c0d3z3r0/qiroll_rev/PICTURES.md

# Qiroll E-PRO Reverse Engineering : Pictures

## Battery


Note: that blue push button was added by me





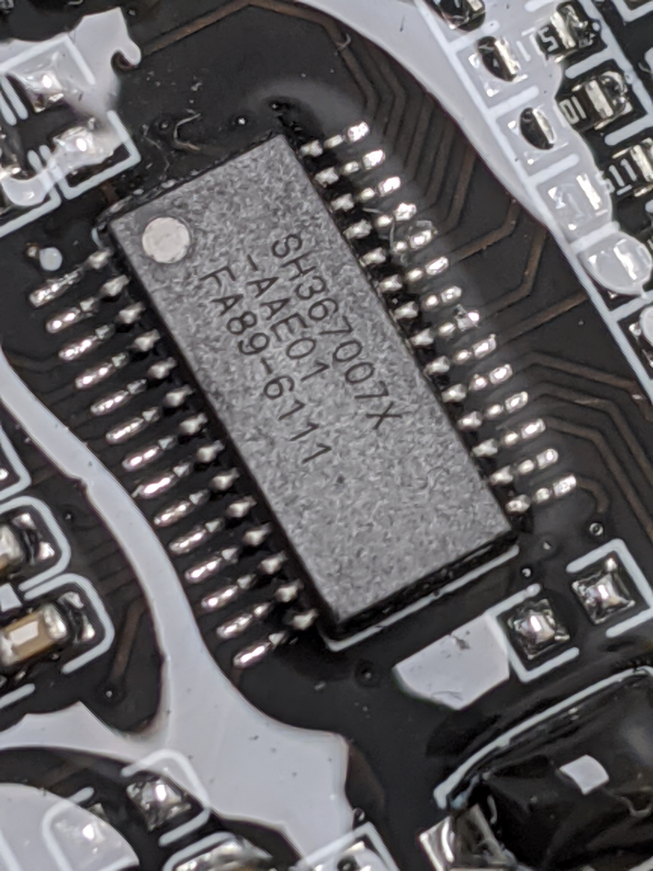
[picture p2: images/battery_pcb_SH367007.jpg]


## S2 Switch



## Qiroll disassembly

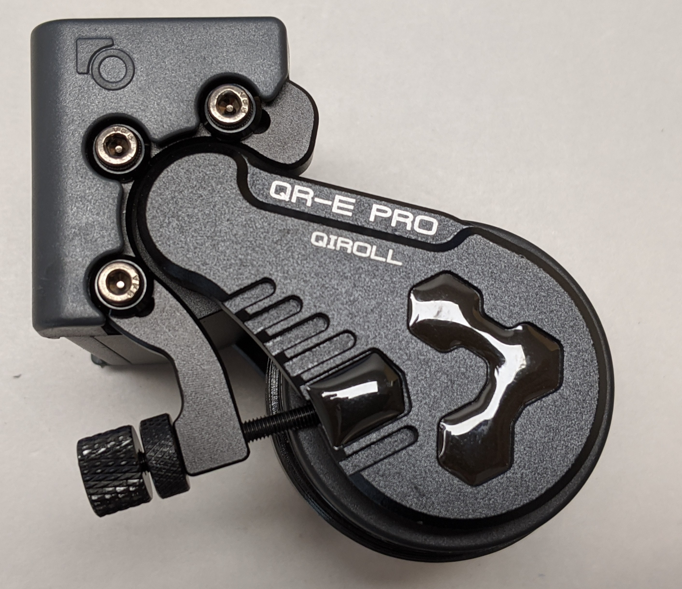
[picture p3: images/qiroll_pro.jpg]



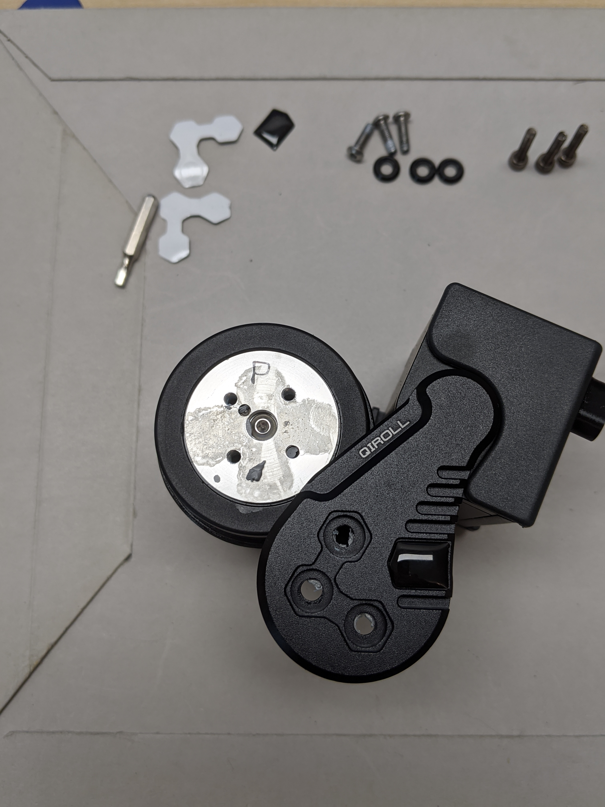
[picture p5: images/qiroll_disassembly_3.jpg]




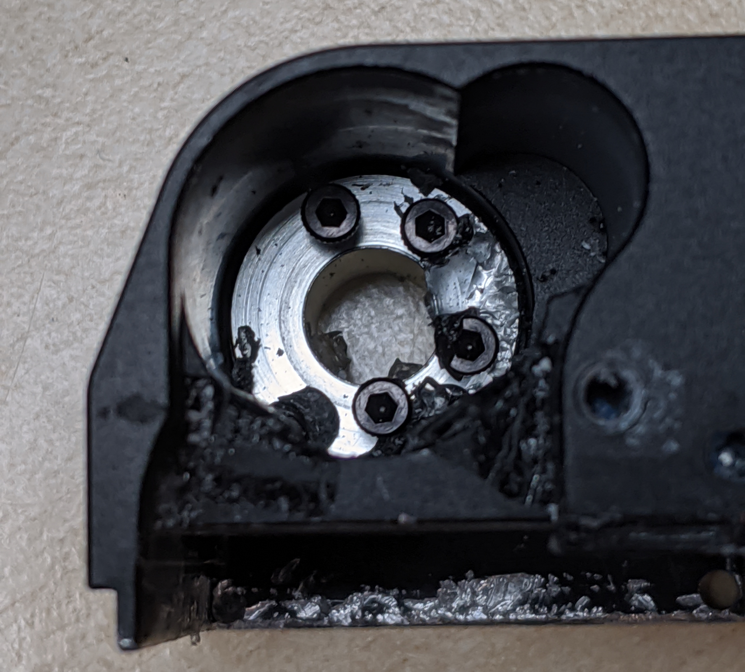
[picture p6: images/qiroll_disassembly_7.jpg]
