c0d3z3r0/qiroll_rev/schematic/qiroll.pdf

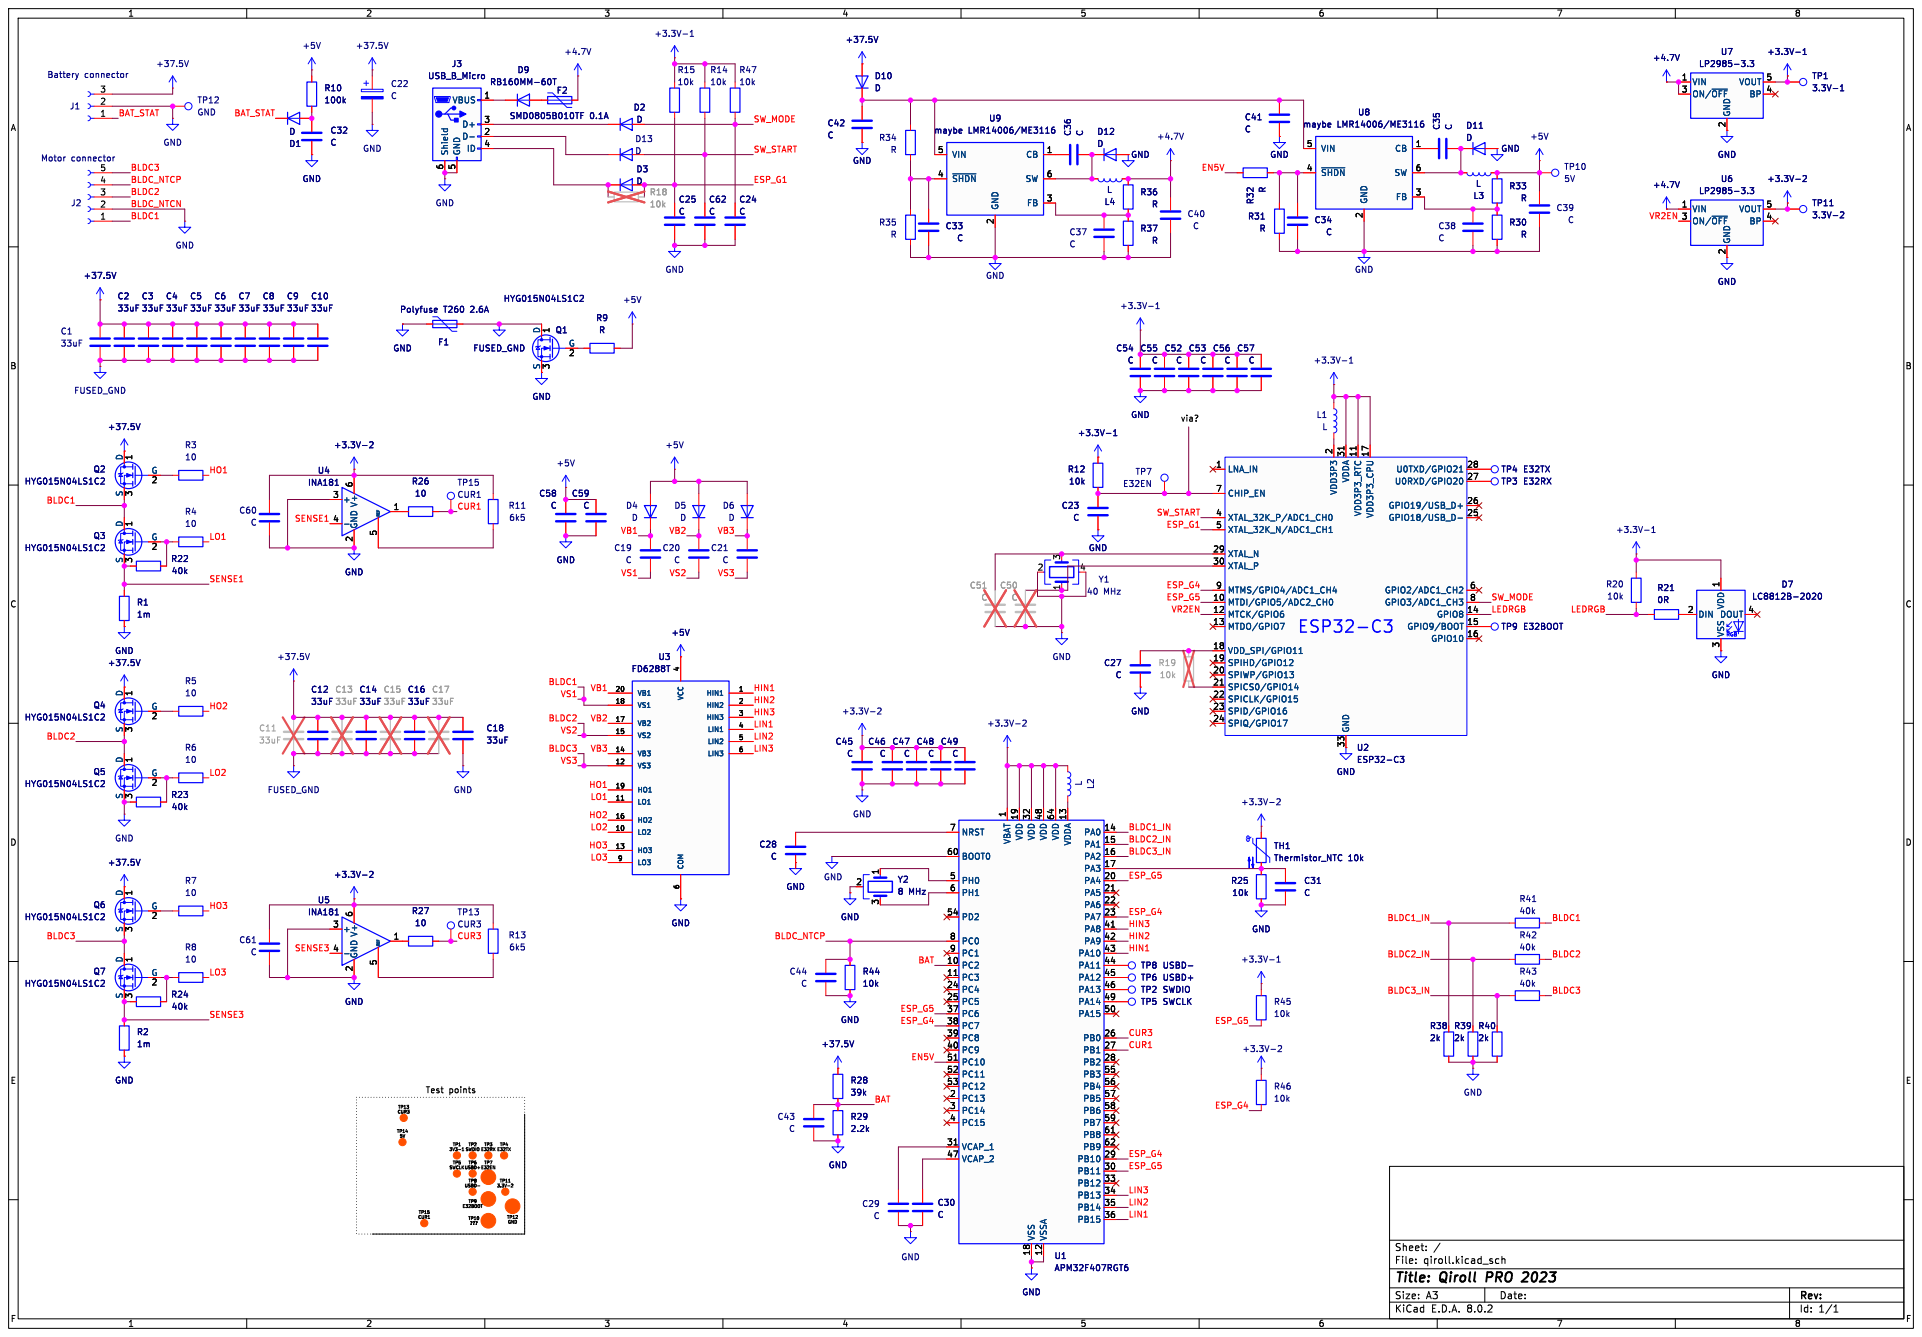
[picture p7: page 1]

2 FB 3 ~{SHDN} 4 VIN 5 SW 6 U9 maybe LMR14006/ME3116 C50C

2 FB 3 ~{SHDN} 4 VIN 5 SW 6 U8 maybe LMR14006/ME3116 C34C

2 FB 3 ~{SHDN} 4 VIN 5 SW 6 D12 D GND C36 C

2 FB 3 ~{SHDN} 4 VIN 5 SW 6 C34C

2 SPIWP/GPIO13 20 SPICS0/GPIO14 21 SPICLK/GPIO15 22 SPID/GPIO16 23 SPIQ/GPIO17 24 GPIO18/USB_D- 25 GPIO19/USB_D+ 26 U0RXD/GPIO20 27 U0TXD/GPIO21 28 XTAL_N 29 XTAL_P 30 VDDA 31 GND 33 XTAL_32K_P/ADC1_CH0 4 XTAL_32K_N/ADC1_CH1 5 GPIO2/ADC1_CH2 6 CHIP_EN 7 GPIO3/ADC1_CH3 8 MTMS/GPIO4/ADC1_CH4 9 U2ESP32-C3

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

1 PC2 10 PC3 11 VSSA 12 VDDA 13 PA0 14 PA1 15 PA2 16 PA3 17 VSS 18 VDD 19 PC13 2 PA4 20 PA5 21 PA6 22 PA7 23 PC4 24 PC5 25 PB0 26 PB1 27 PB2 28 PB10 29 PC14 3 PB11 30 VCAP_1 31 VDD 32 PB12 33 PB13 34 PB14 35 PB15 36 PC6 37 PC7 38 PC8 39 PC15 4 PC9 40 PA8 41 PA9 42 PA10 43 PA11 44 PA12 45 PA13 46 VCAP_2 47 VDD 48 PA14 49 PH0 5 PA15 50 PC10 51 PC11 52 PC12 53 PD2 54 PB3 55 PB4 56 PB5 57 PB6 58 PB7 59 PH1 6 BOOT0 60 PB8 61 PB9 62 VDD 64 NRST 7 PC0 8 PC1 9 C27C GND

1 PC2 10 PC3 11 VSSA 12 VDDA 13 PA0 14 PA1 15 PA2 16 PA3 17 VSS 18 VDD 19 PC13 2 PA4 20 PA5 21 PA6 22 PA7 23 PC4 24 PC5 25 PB0 26 PB1 27 PB2 28 PB10 29 PC14 3 PB11 30 VCAP_1 31 VDD 32 PB12 33 PB13 34 PB14 35 PB15 36 PC6 37 PC7 38 PC8 39 PC15 4 PC9 40 PA8 41 PA9 42 PA10 43 PA11 44 PA12 45 PA13 46 VCAP_2 47 VDD 48 PA14 49 PH0 5 PA15 50 PC10 51 PC11 52 PC12 53 PD2 54 PB3 55 PB4 56 PB5 57 PB6 58 PB7 59 PH1 6 BOOT0 60 PB8 61 PB9 62 VDD 64 NRST 7 PC0 8 PC1 9 U1APM32F407RGT6 GND

File: qiroll.kicad_sch Sheet: /
Id: 1/1 Title: Qiroll PRO 2023
