c0d3z3r0/qiroll_rev/schematic/qiroll.kicad_sch

## KiCad design schematic/qiroll.kicad_sch (2024-08-11)

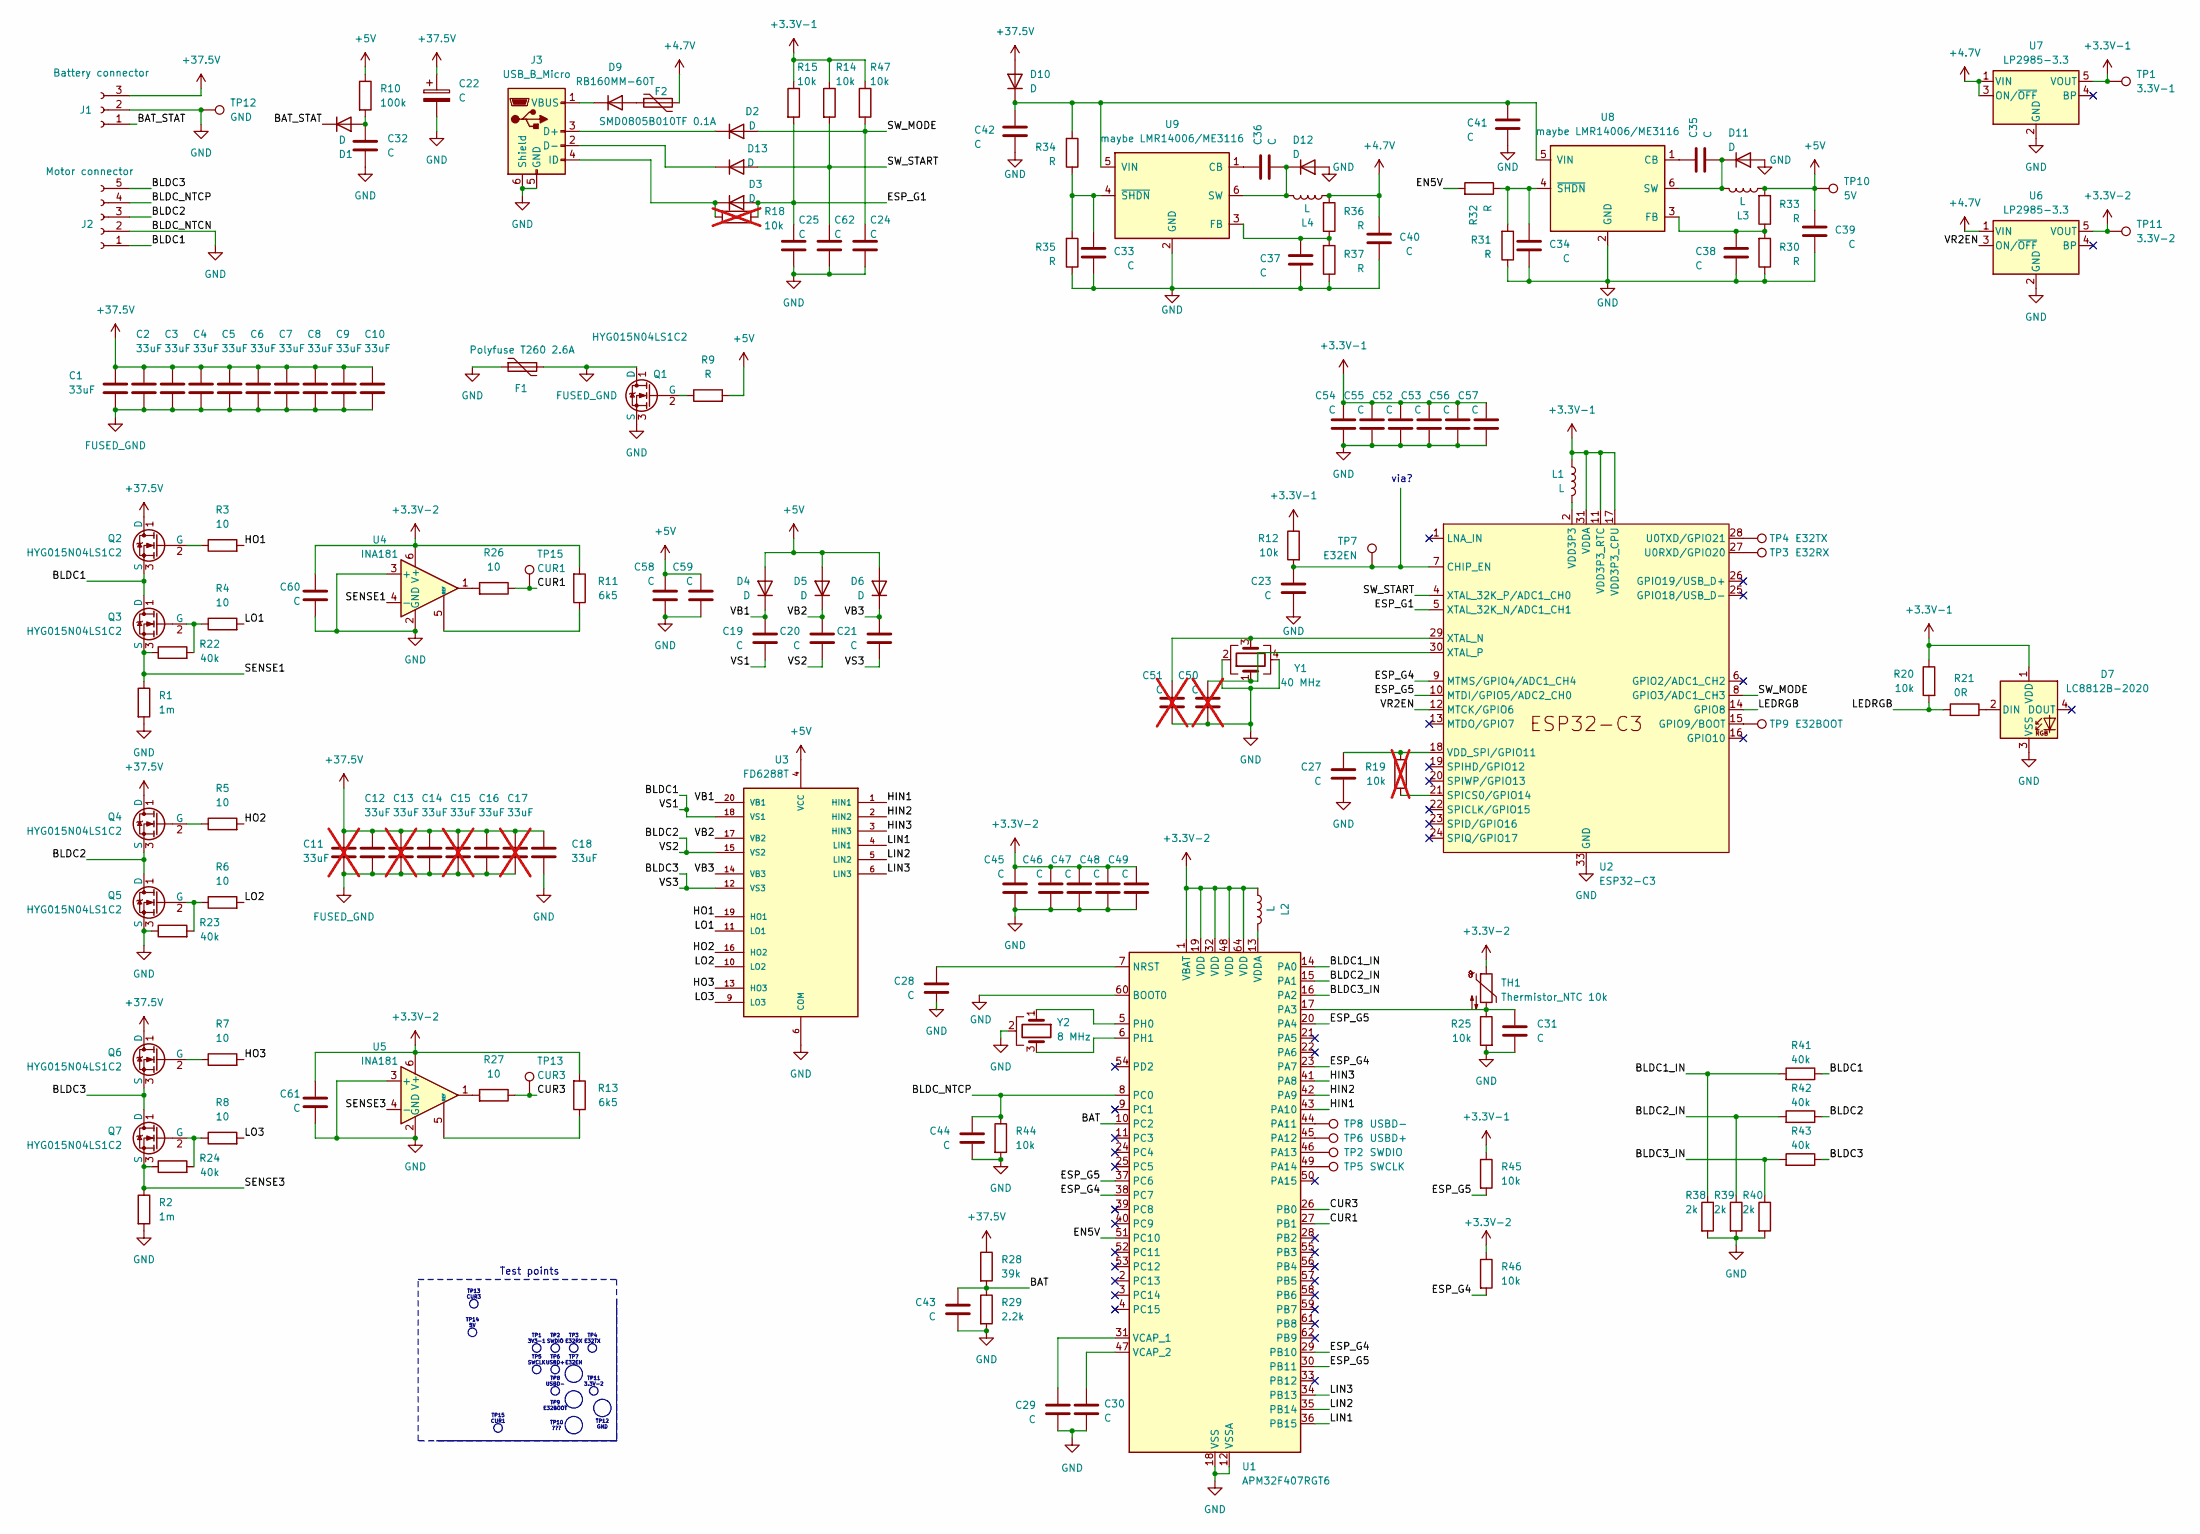
[picture p8: schematic qiroll.kicad_sch]

Parts:
C1, C2, C3, C4, C5, C6, C7, C8, C9, C10, C12, C14, C16, C18: 33uF
C11, C13, C15, C17: 33uF; not fitted
C19, C20, C21, C22, C23, C24, C25, C27, C28, C29, C30, C31, C32, C33, C34, C35, C36, C37, C38, C39, C40, C41, C42, C43, C44, C45, C46, C47, C48, C49, C52, C53, C54, C55, C56, C57, C58, C59, C60, C61, C62: C
C50, C51: C; not fitted
D1, D4, D5, D6: D; D_SOD-323
D2, D3, D10, D11, D12, D13: D
D7: LC8812B-2020; LED_WS2812B-2020_PLCC4_2.0x2.0mm
D9: RB160MM-60T
F1: Polyfuse T260 2.6A
F2: SMD0805B010TF 0.1A
J1: Battery connector
J2: Motor connector
J3: USB_B_Micro
L1, L2, L3, L4: L
Q1, Q2, Q3, Q4, Q5, Q6, Q7: HYG015N04LS1C2
R1, R2: 1m
R3, R4, R5, R6, R7, R8, R26, R27: 10
R9, R30, R31, R32, R33, R34, R35, R36, R37: R
R10: 100k
R11, R13: 6k5
R12, R14, R15, R20, R25, R44, R45, R46, R47: 10k
R18, R19: 10k; not fitted
R21: 0R
R22, R23, R24, R41, R42, R43: 40k
R28: 39k
R29: 2.2k
R38, R39, R40: 2k
TH1: Thermistor_NTC 10k
TP1: 3.3V-1
TP2: SWDIO
TP3: E32RX
TP4: E32TX
TP5: SWCLK
TP6: USBD+
TP7: E32EN
TP8: USBD-
TP9: E32BOOT
TP10: 5V
TP11: 3.3V-2
TP12: GND
TP13: CUR3
TP15: CUR1
U1: APM32F407RGT6; LQFP-64_10x10mm_P0.5mm
U2: ESP32-C3; QFN-32-1EP_5x5mm_P0.5mm_EP3.45x3.45mm
U3: FD6288T; TSSOP-20
U4, U5: INA181; SOT-23-6
U6, U7: LP2985-3.3; SOT-23-5
U8, U9: maybe LMR14006/ME3116; SOT-23-6
Y1: 40 MHz
Y2: 8 MHz

Connections:
+3.3V-1: C52.1, C53.1, C54.1, C55.1, C56.1, C57.1, D7.1 (VDD), L1.2, R12.1, R14.1, R15.1, R20.1, R45.1, R47.1, TP1.1, U2.11 (VDD3P3_RTC), U2.17 (VDD3P3_CPU), U2.31 (VDDA), U2.32 (VDDA), U7.5 (VOUT)
+3.3V-2: C45.1, C46.1, C47.1, C48.1, C49.1, C60.1, C61.1, L2.1, R11.2, R13.2, R46.1, TH1.1, TP11.1, U1.1 (VBAT), U1.19 (VDD), U1.32 (VDD), U1.48 (VDD), U1.64 (VDD), U4.6 (V+), U5.6 (V+), U6.5 (VOUT)
+4.7V: C40.1, F2.2, L4.2, R36.2, U6.1 (VIN), U7.1 (VIN), U7.3 (ON/~OFF)
+5V: C39.1, C58.1, C59.1, D4.2 (A), D5.2 (A), D6.2 (A), L3.2, R9.2, R10.1, R33.2, TP10.1, U3.4 (VCC)
+37.5V: C1.1, C2.1, C3.1, C4.1, C5.1, C6.1, C7.1, C8.1, C9.1, C10.1, C11.1, C12.1, C13.1, C14.1, C15.1, C16.1, C17.1, C18.1, C22.1, D10.2 (A), J1.3, Q2.1 (D), Q4.1 (D), Q6.1 (D), R28.1
BAT: C43.1, R28.2, R29.1, U1.10 (PC2)
BAT_STAT: D1.1 (K), J1.1
BLDC1: C19.2, J2.1, Q2.3 (S), Q3.1 (D), R41.1, U3.18 (VS1)
BLDC1_IN: R38.1, R41.2, U1.14 (PA0)
BLDC2: C20.2, J2.3, Q4.3 (S), Q5.1 (D), R42.1, U3.15 (VS2)
BLDC2_IN: R39.1, R42.2, U1.15 (PA1)
BLDC3: C21.2, J2.5, Q6.3 (S), Q7.1 (D), R43.1, U3.12 (VS3)
BLDC3_IN: R40.1, R43.2, U1.16 (PA2)
BLDC_NTCP: C44.1, J2.4, R44.1, U1.8 (PC0)
CUR1: R26.1, TP15.1, U1.27 (PB1)
CUR3: R27.1, TP13.1, U1.26 (PB0)
EN5V: R32.2, U1.51 (PC10)
ESP_G1: C25.1, D3.2 (A), R15.2, R18.1, U2.5 (XTAL_32K_N/ADC1_CH1)
ESP_G4: R46.2, U1.23 (PA7), U1.29 (PB10), U1.38 (PC7), U2.9 (MTMS/GPIO4/ADC1_CH4)
ESP_G5: R45.2, U1.20 (PA4), U1.30 (PB11), U1.37 (PC6), U2.10 (MTDI/GPIO5/ADC2_CH0)
FUSED_GND: C1.2, C2.2, C3.2, C4.2, C5.2, C6.2, C7.2, C8.2, C9.2, C10.2, C11.2, C12.2, C13.2, C14.2, C15.2, C16.2, C17.2, F1.2, Q1.1 (D)
GND: C18.2, C22.2, C23.2, C24.2, C25.2, C27.2, C28.2, C29.1, C30.1, C31.2, C32.2, C33.2, C34.2, C37.2, C38.2, C39.2, C40.2, C41.2, C42.2, C43.2, C44.2, C45.2, C46.2, C47.2, C48.2, C49.2, C50.2, C51.2, C52.2, C53.2, C54.2, C55.2, C56.2, C57.2, C58.2, C59.2, C60.2, C61.2, C62.2, D7.3 (VSS), D11.2 (A), D12.2 (A), F1.1, J1.2, J2.2, J3.5 (GND), J3.6 (Shield), Q1.3 (S), Q5.3 (S), R1.2, R2.2, R23.1, R25.2, R29.2, R30.1, R31.1, R35.1, R37.1, R38.2, R39.2, R40.2, R44.2, TP12.1, U1.12 (VSSA), U1.18 (VSS), U1.60 (BOOT0), U1.63 (VSS), U2.33 (GND), U3.6 (COM), U4.2 (GND), U4.3 (+), U5.2 (GND), U5.3 (+), U6.2 (GND), U7.2 (GND), U8.2 (GND), U9.2 (GND), Y1.2, Y1.4, Y2.2
HIN1: U1.43 (PA10), U3.1 (HIN1)
HIN2: U1.42 (PA9), U3.2 (HIN2)
HIN3: U1.41 (PA8), U3.3 (HIN3)
HO1: R3.2, U3.19 (HO1)
HO2: R5.2, U3.16 (HO2)
HO3: R7.2, U3.13 (HO3)
LEDRGB: R20.2, R21.2, U2.14 (GPIO8)
LIN1: U1.36 (PB15), U3.4 (VCC)
LIN2: U1.35 (PB14), U3.5 (LIN2)
LIN3: U1.34 (PB13), U3.6 (COM)
LO1: R4.2, U3.11 (LO1)
LO2: R6.2, U3.10 (LO2)
LO3: R8.2, U3.9 (LO3)
unnamed: C23.1, R12.2, TP7.1, U2.7 (CHIP_EN)
unnamed: C27.1, R19.1, U2.18 (VDD_SPI/GPIO11)
unnamed: C28.1, U1.7 (NRST)
unnamed: C29.2, U1.31 (VCAP_1)
unnamed: C30.2, U1.47 (VCAP_2)
unnamed: C31.1, R25.1, TH1.2, U1.17 (PA3)
unnamed: C32.1, D1.2 (A), R10.2
unnamed: C33.1, R34.1, R35.2, U9.4 (~SHDN)
unnamed: C34.1, R31.2, R32.1, U8.4 (~SHDN)
unnamed: C35.1, U8.1 (CB)
unnamed: C35.2, D11.1 (K), L3.1, U8.6 (SW)
unnamed: C36.1, U9.1 (CB)
unnamed: C36.2, D12.1 (K), L4.1, U9.6 (SW)
unnamed: C37.1, R36.1, R37.2, U9.3 (FB)
unnamed: C38.1, R30.2, R33.1, U8.3 (FB)
unnamed: C41.1, C42.1, D10.1 (K), R34.2, U8.5 (VIN), U9.5 (VIN)
unnamed: C50.1, U2.30 (XTAL_P), Y1.1
unnamed: C51.1, U2.29 (XTAL_N), Y1.3
unnamed: D2.1 (K), J3.3 (D+)
unnamed: D3.1 (K), J3.4 (ID), R18.2
unnamed: D7.2 (DIN), R21.1
unnamed: D9.1 (K), J3.1 (VBUS)
unnamed: D9.2 (A), F2.1
unnamed: D13.1 (K), J3.2 (D-)
unnamed: L1.1, U2.2 (VDD3P3), U2.3 (VDD3P3)
unnamed: L2.2, U1.13 (VDDA)
unnamed: Q1.2 (G), R9.1
unnamed: Q2.2 (G), R3.1
unnamed: Q3.2 (G), R4.1, R22.2
unnamed: Q4.2 (G), R5.1
unnamed: Q5.2 (G), R6.1, R23.2
unnamed: Q6.2 (G), R7.1
unnamed: Q7.2 (G), R8.1, R24.2
unnamed: R11.1, U4.5 (REF)
unnamed: R13.1, U5.5 (REF)
unnamed: R19.2, U2.21 (SPICS0/GPIO14)
unnamed: R26.2, U4.1
unnamed: R27.2, U5.1
unnamed: TP2.1, U1.46 (PA13)
unnamed: TP3.1, U2.27 (U0RXD/GPIO20)
unnamed: TP4.1, U2.28 (U0TXD/GPIO21)
unnamed: TP5.1, U1.49 (PA14)
unnamed: TP6.1, U1.45 (PA12)
unnamed: TP8.1, U1.44 (PA11)
unnamed: TP9.1, U2.15 (GPIO9/BOOT)
unnamed: U1.5 (PH0), Y2.1
unnamed: U1.6 (PH1), Y2.3
SENSE1: Q3.3 (S), R1.1, R22.1, U4.4 (-)
SENSE3: Q7.3 (S), R2.1, R24.1, U5.4 (-)
SW_MODE: C24.1, D2.2 (A), R47.2, U2.8 (GPIO3/ADC1_CH3)
SW_START: C62.1, D13.2 (A), R14.2, U2.4 (XTAL_32K_P/ADC1_CH0)
VB1: C19.1, D4.1 (K), U3.20 (VB1)
VB2: C20.1, D5.1 (K), U3.17 (VB2)
VB3: C21.1, D6.1 (K), U3.14 (VB3)
VR2EN: U2.12 (MTCK/GPIO6), U6.3 (ON/~OFF)

Notes on the sheet:
TP11 3.3V-2
Test points
TP8 USBD-
TP3 E32RX
TP10 ???
TP6 USBD+
TP5 SWCLK
TP14 5V
TP7 E32EN
TP13 CUR3
TP1 3V3-1
TP15 CUR1
TP9 E32BOOT
TP12 GND
TP2 SWDIO
TP4 E32TX
via?
