c0d3z3r0/qiroll_rev/(commit log)

2024-07-15 Initial release
    [qiroll.kicad_sch]
2024-07-19 Finished schematic
    [qiroll.kicad_sch]
2024-07-24 schematic: label USB+/- testpads and correct ESP_G4 pull-up voltage
    [qiroll.kicad_sch]
2024-07-24 schematic: correct switch connections
    [qiroll.kicad_sch]
2024-07-25 readme: the motor is a outrunner, probably
2024-07-28 schematic: PA3 is connected to NTC, not resistor
    [qiroll.kicad_sch]
2024-08-11 schematic: correct buttons once again
    [qiroll.kicad_sch]
2024-08-14 Add current ESP32 fw RE state
