c0d3z3r0/qiroll_rev/images/qiroll_disassembly_1.jpg

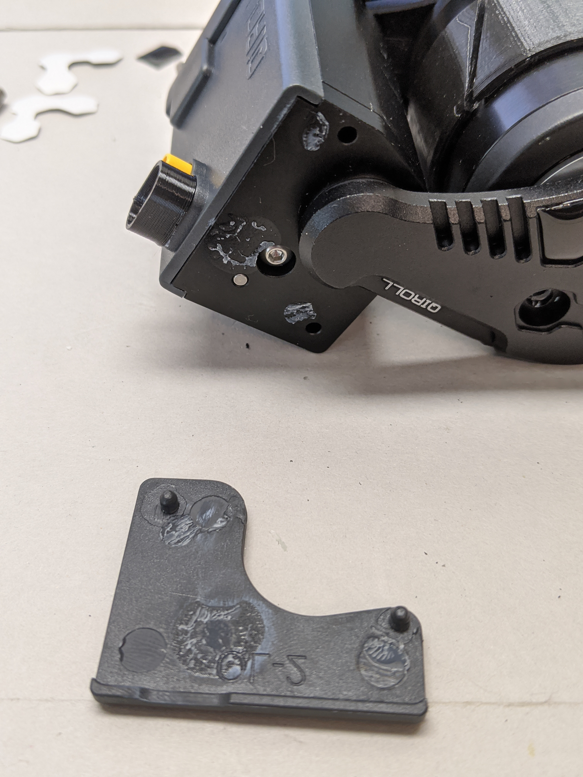
[picture p4: images/qiroll_disassembly_1.jpg]
images/qiroll_disassembly_1.jpg
